DaMon-14/Micromouse/resources/links.txt

https://wiki.st.com/stm32mcu/wiki/Getting_started_with_SPI
https://www.youtube.com/watch?v=vKyL43qXPpk
http://greenye.net/
