DaMon-14/Micromouse/piese.xlsx

Sheet: parts
item # | component | manufacturer | vendor | Qty | Unit price no TVA | Unit price | Total Price | Y/N | min qty | Notes | In stock | Url | Alt Url
1 | NUCLEO-F411RE | STMicroelectronics | TME | 1 | 104.31 | 104.31 | 104.31 | 1 | 1 |  | 0 | NUCLEO-F411RE STMicroelectronics - Kituri dezv: STM32 | Comp: STM32F411RET6; Conectori de extensie: 2 | Transfer Multisort Elektronik România (https://www.tme.eu/ro/details/nucleo-f411re/kituri-de-dezvoltare-stm/stmicroelectronics/) | NUCLEO-F411RE STMicroelectronics | Embedded MCU, DSP Evaluation Boards | DigiKey (https://www.digikey.ro/en/products/detail/stmicroelectronics/NUCLEO-F411RE/4866485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)
2 | LSM6DSOXTR test board | Arduino | TME | 1 | 73.54 | 73.54 | 73.54 | 1 | 1 |  | 0 | MODULINO MOVEMENT ARDUINO - Modul de extensie | cablu de conectare,modul; Comp: LSM6DSOX; ABX00101 | Transfer Multisort Elektronik România (https://www.tme.eu/ro/details/abx00101/solutii-arduino/arduino/modulino-movement/) | 4438 Adafruit Industries LLC | Expansion Boards, Daughter Cards | DigiKey (https://www.digikey.ro/en/products/detail/adafruit-industries-llc/4438/11497501)
3 | 8.00M-SMDHC49S | YIC | TME | 10 | 1.44 | 1.44 | 14.4 | 1 | 10 |  | 0 | 8.00M-SMDHC49S YIC - Cristal | 8MHz; SMD; 20pF; ±30ppm; ±5ppm/an; 1mW; HC49SM; -20÷70°C | Transfer Multisort Elektronik România (https://www.tme.eu/ro/details/8.00m-smdhc49s/resonators-and-generators/yic/) | ABLS-8.000MHZ-B4-T Abracon LLC | Crystals | DigiKey (https://www.digikey.ro/en/products/detail/abracon-llc/ABLS-8-000MHZ-B4-T/2184155)
4 | RGB LED | REFOND | TME | 5 | 0.82 | 0.82 | 4.1 | 1 | 5 |  | 0 | RF-W7SP30TS-A44 REFOND - LED | RGB; SMD; PLCC6; 1,8÷2,4/2,7÷3,4/2,7÷3,4VDC; 3,5x2,8x1,8mm | Transfer Multisort Elektronik România (https://www.tme.eu/ro/details/rf-w7sp30ts-a44/diode-led-smd-colorate/refond/) | CLMVC-FKA-CL1D1L71BB7C3C3 Cree LED | LED Indication - Discrete | DigiKey (https://www.digikey.ro/en/products/detail/cree-led/CLMVC-FKA-CL1D1L71BB7C3C3/4794065)
18 | HC-05 |  | Sigmanortec | 1 |  | 27.04 | 27.04 | 1 | 1 |  | 1 | Modul Bluetooth HC-05 compatibil Arduino Master/Slave (https://sigmanortec.ro/Modul-Bluetooth-HC-05-p141736971)
19 | SS14 |  | Sigmanortec | 10 |  | 0.3 | 3 | 1 | 1 |  | 1 | Dioda Schottky 1N5819 SMD SS14 40V 1A (https://sigmanortec.ro/Dioda-Schottky-1N5819-SMD-SS14-40V-p128704286)
20 | Button |  | Sigmanortec | 10 |  | 0.73 | 7.3 | 1 | 1 |  | 1 | Buton micro fara retinere 4x4x1.6mm, 4 pini metalic (https://sigmanortec.ro/Buton-micro-fara-retinere-1-6mm-p125704779)
21 | HPCB 30:1 1000rpm |  | Sigmanortec | 3 |  | 38.72 | 116.16 | 1 | 1 |  | 0 | Motor DC Micro Metal N20 6V HPCB perii carbon 30:1 (https://sigmanortec.ro/Motor-DC-Micro-Metal-6V-HPCB-Perii-Carbon-30-1-p200733572)
22 | coreless motor |  | Sigmanortec | 3 |  | 12.63 | 37.89 | 1 | 1 |  | 0 | Motor mini coreless 20x8.5 ax 1mm 50000RPM 3.7V drone (https://sigmanortec.ro/Motor-mini-coreless-20x8-5-ax-1mm-50000RPM-p209682505)
5 | NOVOSENSE MT6701CT-ACD | NOVOSENSE | LCSC | 4 | 9.54 | 11.5434 | 46.1736 | 1 | 1 |  | 0 | MT6701CT-ACD | Angle, Linear Position Measuring | NOVOSENSE | LCSC (https://www.lcsc.com/product-detail/C50203010.html?s_z=n_q_MT6701CT-ACD)
6 | TB6612FNG | Toshiba Semiconductor and Storage | LCSC | 2 | 5.4 | 6.534 | 13.068 | 1 | 1 |  | 0 | TB6612FNG,C,8,EL | Motor Drivers, Controllers | TOSHIBA | LCSC (https://www.lcsc.com/product-detail/C141517.html?s_z=n_q_TB6612FNG) | TB6612FNG,C,8,EL Toshiba Semiconductor and Storage | Motor Drivers, Controllers | DigiKey (https://www.digikey.ro/en/products/detail/toshiba-semiconductor-and-storage/TB6612FNG-C-8-EL/1730070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)
7 | TEFT4300 | Vishay Semiconductor Opto Division | LCSC | 10 | 1.09 | 1.3189 | 13.189 | 1 | 5 |  | 0 | TEFT4300 | Phototransistors | VISHAY | LCSC (https://www.lcsc.com/product-detail/C118301.html?s_z=n_q_TEFT4300) | TEFT4300 Vishay Semiconductor Opto Division | Phototransistors | DigiKey (https://www.digikey.ro/en/products/detail/vishay-semiconductor-opto-division/TEFT4300/1681175)
8 | STM32F411RET6 | STMicroelectronics | LCSC | 2 | 21.18 | 25.6278 | 51.2556 | 1 | 1 |  | 0 | STM32F411RET6 | Microcontrollers | ST | LCSC (https://www.lcsc.com/product-detail/C94355.html?s_z=n_q_STM32F411RET6) | STM32F411RET6 STMicroelectronics | Microcontrollers | DigiKey (https://www.digikey.ro/en/products/detail/stmicroelectronics/STM32F411RET6/4935722)
9 | LSM6DSOXTR | STMicroelectronics | LCSC | 1 | 17.67 | 21.3807 | 21.3807 | 1 | 1 |  | 0 | LSM6DSOXTR | IMUs (Inertial Measurement Units) | ST | LCSC (https://www.lcsc.com/product-detail/C481766.html?s_z=n_q_LSM6DSOXTR) | LSM6DSOXTR STMicroelectronics | IMUs (Inertial Measurement Units) | DigiKey (https://www.digikey.ro/en/products/detail/stmicroelectronics/LSM6DSOXTR/9841882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)
10 | TSAL6100 | Vishay Semiconductor Opto Division | LCSC | 10 | 0.92 | 1.1132 | 11.132 | 1 | 5 |  | 0 | TSAL6100 | LED Emitters - Infrared, UV, Visible | VISHAY | LCSC (https://www.lcsc.com/product-detail/C111836.html?s_z=n_q_TSAL6100) | TSAL6100 Vishay Semiconductor Opto Division | LED Emitters - Infrared, UV, Visible | DigiKey (https://www.digikey.ro/en/products/detail/vishay-semiconductor-opto-division/TSAL6100/1681338)
11 | BPV10NF | Vishay Semiconductor Opto Division | LCSC | 10 | 2.52 | 3.0492 | 30.492 | 0.5 | 10 |  | 0 | BPV10NF | Photodiodes | VISHAY | LCSC (https://www.lcsc.com/product-detail/C118288.html?s_z=n_q_BPV10NF) | BPV10NF Vishay Semiconductor Opto Division | Photodiodes | DigiKey (https://www.digikey.ro/en/products/detail/vishay-semiconductor-opto-division/BPV10NF/1681136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)
12 | TLV9062IDR | Texas Instruments | LCSC | 10 | 0.71 | 0.8591 | 8.591 | 0.5 | 5 |  | 0 | TLV9062IDR | Instrumentation, Op Amps, Buffer Amps | TI | LCSC (https://www.lcsc.com/product-detail/C398355.html?s_z=n_q_x_TLV9062IDR) | TLV9062IDR Texas Instruments | Instrumentation, Op Amps, Buffer Amps | DigiKey (https://www.digikey.ro/en/products/detail/texas-instruments/TLV9062IDR/7364940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)
13 | AO3400A | UMW | LCSC | 50 | 0.31 | 0.3751 | 18.755 | 1 | 10 |  | 0 | AO3400A | Single FETs, MOSFETs | AOS | LCSC (https://www.lcsc.com/product-detail/C20917.html?s_z=n_q_AO3400A) | AO3400A UMW | Single FETs, MOSFETs | DigiKey (https://www.digikey.ro/en/products/detail/umw/AO3400A/16705910)
14 | AP62300Z6-7 | Diodes Incorporated | LCSC | 10 | 0.96 | 1.1616 | 11.616 | 1 | 5 |  | 0 | AP62300Z6-7 | Voltage Regulators - DC DC Switching Regulators | DIODES | LCSC (https://www.lcsc.com/product-detail/C5250745.html?s_z=n_q_AP62300Z6-7) | AP62300Z6-7 Diodes Incorporated | Voltage Regulators - DC DC Switching Regulators | DigiKey (https://www.digikey.ro/en/products/detail/diodes-incorporated/AP62300Z6-7/16547279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)
15 | APV APH0420T3R3M | APV | LCSC | 10 | 0.42 | 0.5082 | 5.082 | 1 | 5 |  | 0 | APH0420T3R3M | Fixed Inductors | APV | LCSC (https://www.lcsc.com/product-detail/C5349667.html?s_z=n_q_t_3.3uH) | NRS5040T3R3NMGJ Taiyo Yuden | Fixed Inductors | DigiKey (https://www.digikey.ro/en/products/detail/taiyo-yuden/NRS5040T3R3NMGJ/4970846)
16 | TLV75533PDBVR | Texas Instruments | LCSC | 10 | 0.78 | 0.9438 | 9.438 | 1 | 5 |  | 0 | TLV75533PDBVR | Voltage Regulators - Linear, Low Drop Out (LDO) Regulators | TI | LCSC (https://www.lcsc.com/product-detail/C404027.html?s_z=n_q_TLV75533PDBVR) | TLV75533PDBVR Texas Instruments | Voltage Regulators - Linear, Low Drop Out (LDO) Regulators | DigiKey (https://www.digikey.ro/en/products/detail/texas-instruments/TLV75533PDBVR/9356541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)
17 | TVS encoder | TECH PUBLIC | LCSC | 20 | 0.14 | 0.1694 | 3.388 | 1 | 20 |  | 0 | PESD3V3U1UL | TVS Diodes | TECH PUBLIC | LCSC (https://www.lcsc.com/product-detail/C19829543.html?s_z=n_q_ESD3V3U1U)
23 | magnet |  |  |  |  | 0 | 0 | 1 |  |  | 1 | DecoHobbyArt, or any other generic magnets
 | Total Price
 | 631.3009
 |  |  |  |  |  | 243.56

Sheet: parts_old
part & likelyhood of purchase | link | price/pcs | pcs | price | Obs | purchased? | JLCPCB avalibility | JLCPCB price | Obs
SLM6DSOX | MODULINO MOVEMENT ARDUINO - Modul de extensie | cablu de conectare,modul; Comp: LSM6DSOX; ABX00101 | Transfer Multisort Elektronik România (https://www.tme.eu/ro/details/abx00101/solutii-arduino/arduino/modulino-movement/) | 60.87 | 1 | 60.87
NUCELO-F411RE | NUCLEO-F411RE STMicroelectronics - Kituri dezv: STM32 | Comp: STM32F411RET6; Conectori de extensie: 2 | Transfer Multisort Elektronik România (https://www.tme.eu/ro/details/nucleo-f411re/kituri-de-dezvoltare-stm/stmicroelectronics/) | 86.63 | 1 | 86.63
TSAL6200 | TSAL6200 VISHAY - Emiţător IR | 5mm; 940nm; gri-albăstrui,transparent; 210mW; 17° | Transfer Multisort Elektronik România (https://www.tme.eu/ro/details/tsal6200/diode-led-ir/vishay/) | 1.35 | 10 | 13.5 | price 10 buc min
TSAL6100 | TSAL6100 VISHAY - Emiţător IR | 5mm; 940nm; gri-albăstrui,transparent; 40mW; THT | Transfer Multisort Elektronik România (https://www.tme.eu/ro/details/tsal6100/diode-led-ir/vishay/) | 1.79 | 10 | 17.9 | price 10 buc min
SFH4544 | SFH 4544 ams OSRAM - Emiţător IR | 5mm; 950nm; neagră; 550mW; 10°; 1,6÷1,9VDC; THT; 100mA; SFH4544 | Transfer Multisort Elektronik România (https://www.tme.eu/ro/details/sfh4544/diode-led-ir/ams-osram/sfh-4544/) | 2.24 | 10 | 22.4 | price 10 buc min |  | 34 in stock only | 2.37 | price 10 buc min
VBPW34S | VBPW34S VISHAY - Fotodiodă PIN | Gull wing; SMD; 940nm; 430÷1100nm; 130°; plat | Transfer Multisort Elektronik România (https://www.tme.eu/ro/details/vbpw34s/fotodiode/vishay/) | 3.78 | 10 | 37.8 | price 10 buc min |  |  | 2.18 | price 10 buc min
BPV10NF | BPV10NF VISHAY - Fotodiodă IR PIN | 5mm; THT; 940nm; 40° | Transfer Multisort Elektronik România (https://www.tme.eu/ro/details/bpv10nf/fotodiode/vishay/) | 3.16 | 10 | 31.6 | price 10 buc min |  |  | 2.46 | price 10 buc min
TLV9062IDR | TLV9062IDR TEXAS INSTRUMENTS - IC: amplificator operaţional | 10MHz; Ch: 2; 1,8÷5,5VDC; SO8; 2mV | Transfer Multisort Elektronik România (https://www.tme.eu/ro/details/tlv9062idr/amplificatori-operationali-smd/texas-instruments/) | 3.61 | 10 | 36.1 | price 10 buc min |  |  | 0.64
AO3400A | AO3400A ALPHA & OMEGA SEMICONDUCTOR - Tranzistor: N-MOSFET | unipolar; 30V; 4,7A; 1,4W; SOT23 | Transfer Multisort Elektronik România (https://www.tme.eu/ro/details/ao3400a/tranzistori-canal-n-smd/alpha-omega-semiconductor/) | 0.37 | 50 | 18.5 | price 50 buc min |  |  | 0.38
TCTR5000 | TCRT5000 2.5mm reflective optical sensor for line robots (https://sigmanortec.ro/en/tcrt5000-optical-sensor-reflective) | 3.55 | 10 | 35.5 | backup if photodiode is problematic
Motor | Motor DC mini N20 500RPM 6V cu reductor metalic (https://sigmanortec.ro/Motor-DC-mini-angrenaje-metal-N20-500RPM-p211611036) | 22.46 | 3 | 67.38 | no encoder, may be changed with 1000rpm HPCB variant from sigmanortec
DRV8833 | DRV8833 dual H-bridge 1.5A Arduino motor driver module (https://sigmanortec.ro/en/motor-driver-module-dual-h-bridge-drv8833-15a) | 6.09 | 1 | 6.09 |  |  |  | 10.38
turbine motor | Motor mini coreless 20x8.5 ax 1mm 50000RPM 3.7V drone (https://sigmanortec.ro/Motor-mini-coreless-20x8-5-ax-1mm-50000RPM-p209682505) | 12.63 | 4 | 50.52
8Mhz quartz | 8.00M-SMDHC49S YIC - Cristal | 8MHz; SMD; 20pF; ±30ppm; ±5ppm/an; 1mW; HC49SM; -20÷70°C | Transfer Multisort Elektronik România (https://www.tme.eu/ro/details/8.00m-smdhc49s/resonators-and-generators/yic/) | 1.19 | 10 | 11.9 | price 10 buc min
Pogo pins | 303A-753018-000 ATTEND - Conector: pogo pin | PIN: 1; SMT; Ø: 1,05mm; Hmin: 6,2mm; Hmax: 7,5mm | Transfer Multisort Elektronik România (https://www.tme.eu/ro/details/303a-753018-000/alti-conectori/attend/) | 2.74 | 5 | 13.7 | price 5 buc min
AP62300Z6-7 | AP62300Z6-7 DIODES INCORPORATED - PMIC | convertor DC/DC; Uintr: 4,2÷18VDC; Uieş: 0,8÷7VDC; 3A; SOT563 | Transfer Multisort Elektronik România (https://www.tme.eu/ro/details/ap62300z6-7/regulatoare-de-tensiune-circuite-dc-dc/diodes-incorporated/) | 1.11 | 10 | 11.1 | price 10 bun min |  |  | 0.73
3.3uH inductor | NRS5030T3R3MMGJ TAIYO YUDEN - Inductor: fir | SMD; 3,3uH; 3A; R: 30mΩ; ±20%; NRS; 4,9x4,9mm | Transfer Multisort Elektronik România (https://www.tme.eu/ro/details/nrs5030t3r3mmgj/inductoare/taiyo-yuden/) | 0.57 | 10 | 5.7 | price 10 buc min |  |  |  | hand solder prob
TLV75533PDBVR | TLV75533PDBVR TEXAS INSTRUMENTS - IC: stabilizator de tensiune | LDO,liniar,nereglabil; 3,3V; 500mA | Transfer Multisort Elektronik România (https://www.tme.eu/ro/details/tlv75533pdbvr/regulatoare-de-tensiune-neregulata-ldo/texas-instruments/) | 1.28 | 5 | 6.4 | price 5 buc min |  |  | 0.73
State led | RF-W7SP30TS-A44 REFOND - LED | RGB; SMD; PLCC6; 1.8÷2.4/2.7÷3.4/2.7÷3.4VDC; 3.5x2.8x1.8mm | Transfer Multisort Elektronik Romania (https://www.tme.eu/ro/en/details/rf-w7sp30ts-a44/smd-colour-leds/refond/) | 0.5 | 25 | 12.5 | price 25 buc min
Button | Buton micro fara retinere 4x4x1.6mm, 4 pini metalic (https://sigmanortec.ro/Buton-micro-fara-retinere-1-6mm-p125704779) | 0.73 | 5 | 3.65
SS14 | Dioda Schottky 1N5819 SMD SS14 40V 1A (https://sigmanortec.ro/Dioda-Schottky-1N5819-SMD-SS14-40V-p128704286) | 0.3 | 10 | 3 |  |  |  | 0.05
BLE | Modul Bluetooth HC-05 compatibil Arduino Master/Slave (https://sigmanortec.ro/Modul-Bluetooth-HC-05-p141736971) | 27.04 | 1 | 27.04
 |  | 479.04

Sheet: general
part | link | price (ron) /pcs | pcs | price (ron) | OK/NOT OK | Obs
STM32 | https://www.digikey.com/en/products/detail/stmicroelectronics/STM32F411RET6/4935722 | 34.35 | 3 | 103.05
 | https://www.tme.eu/ro/details/stm32f411ret6/microcontrolere-st/stmicroelectronics/ | 49.77 | 3 | 149.31 |  | min 3 pcs for that price
nucleo | https://www.digikey.com/en/products/detail/stmicroelectronics/NUCLEO-F411RE/4866485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 | 86.67 | 1 | 86.67
 | https://www.tme.eu/ro/details/nucleo-f411re/kituri-de-dezvoltare-stm/stmicroelectronics/ | 86.35 | 1 | 86.35
 | https://botland.store/stm32-nucleo/3363-stm32-nucleo-f411re-module-stm32f411re-arm-cortex-m4-5904422331764.html | 104.67 | 1 | 104.67
motors | https://www.pololu.com/product/5187 | 149.44 | 2 | 298.88 |  | pricy shiping
 | https://robomaniacs.ro/product/micromotor-cu-angrenaj-core-6v/ | 120 | 2 | 240 |  | 750rpm no encoder
 | https://www.dfrobot.com/product-1431.html | 54.8 | 3 | 164.4 |  | 530rpm encoder | drfobot 18usd shiping
 | https://botland.store/dc-micro-motors-with-gearbox/5093-hpcb-motor-with-50-1-gear-doublesided-shaft-pololu-3073-5904422306359.html |  |  | 0 |  | w/o encoder | https://botland.store/encoders/8258-magnetic-encoder-pair-kit-for-20d-mm-metal-gearmotors-20-cpr-27-18v-pololu-3499-5904422375782.html
 |  |  |  | 0
 |  |  |  | 0
 |  |  |  | 0
 |  |  |  | 0
 |  |  |  | 0
 |  |  |  | 0
 |  |  |  | 0
