DaMon-14/Micromouse/p.xlsx

Sheet: Sheet1
part & liklyhood of purchase | link | price/pcs | pcs | price | Obs | JLCPCB avalibility | JLCPCB price | Obs
SLM6DSOX | MODULINO MOVEMENT ARDUINO - Modul de extensie | cablu de conectare,modul; Comp: LSM6DSOX; ABX00101 | Transfer Multisort Elektronik România (https://www.tme.eu/ro/details/abx00101/solutii-arduino/arduino/modulino-movement/) | 60.87 | 1 | 60.87
NUCELO-F411RE | NUCLEO-F411RE STMicroelectronics - Kituri dezv: STM32 | Comp: STM32F411RET6; Conectori de extensie: 2 | Transfer Multisort Elektronik România (https://www.tme.eu/ro/details/nucleo-f411re/kituri-de-dezvoltare-stm/stmicroelectronics/) | 86.63 | 1 | 86.63
TSAL6200 | TSAL6200 VISHAY - Emiţător IR | 5mm; 940nm; gri-albăstrui,transparent; 210mW; 17° | Transfer Multisort Elektronik România (https://www.tme.eu/ro/details/tsal6200/diode-led-ir/vishay/) | 1.35 | 10 | 13.5 | price 10 buc min
TSAL6100 | TSAL6100 VISHAY - Emiţător IR | 5mm; 940nm; gri-albăstrui,transparent; 40mW; THT | Transfer Multisort Elektronik România (https://www.tme.eu/ro/details/tsal6100/diode-led-ir/vishay/) | 1.79 | 10 | 17.9 | price 10 buc min
SFH4544 | SFH 4544 ams OSRAM - Emiţător IR | 5mm; 950nm; neagră; 550mW; 10°; 1,6÷1,9VDC; THT; 100mA; SFH4544 | Transfer Multisort Elektronik România (https://www.tme.eu/ro/details/sfh4544/diode-led-ir/ams-osram/sfh-4544/) | 2.24 | 10 | 22.4 | price 10 buc min | 34 in stock only | 2.37 | price 10 buc min
VBPW34S | VBPW34S VISHAY - Fotodiodă PIN | Gull wing; SMD; 940nm; 430÷1100nm; 130°; plat | Transfer Multisort Elektronik România (https://www.tme.eu/ro/details/vbpw34s/fotodiode/vishay/) | 3.78 | 10 | 37.8 | price 10 buc min |  | 2.18 | price 10 buc min
BPV10NF | BPV10NF VISHAY - Fotodiodă IR PIN | 5mm; THT; 940nm; 40° | Transfer Multisort Elektronik România (https://www.tme.eu/ro/details/bpv10nf/fotodiode/vishay/) | 3.16 | 10 | 31.6 | price 10 buc min |  | 2.46 | price 10 buc min
TLV9062IDR | TLV9062IDR TEXAS INSTRUMENTS - IC: amplificator operaţional | 10MHz; Ch: 2; 1,8÷5,5VDC; SO8; 2mV | Transfer Multisort Elektronik România (https://www.tme.eu/ro/details/tlv9062idr/amplificatori-operationali-smd/texas-instruments/) | 3.61 | 10 | 36.1 | price 10 buc min |  | 0.64
AO3400A | AO3400A ALPHA & OMEGA SEMICONDUCTOR - Tranzistor: N-MOSFET | unipolar; 30V; 4,7A; 1,4W; SOT23 | Transfer Multisort Elektronik România (https://www.tme.eu/ro/details/ao3400a/tranzistori-canal-n-smd/alpha-omega-semiconductor/) | 0.37 | 50 | 18.5 | price 50 buc min |  | 0.38
TCTR5000 | TCRT5000 VISHAY - Senzor: optocuplor | 32V; OUT: tranzistori | Transfer Multisort Elektronik România (https://www.tme.eu/ro/details/tcrt5000/senzori-fotoelectrici-pt-pcb/vishay/) | 4.36 | 10 | 43.6 | price 10 buc min
 | TCRT5000 Photoelectric Sensor (https://www.optimusdigital.ro/en/optical-sensors/42-tcrt5000-photoelectric-sensor.html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) | 1.79 | 10 | 17.9
Motor | GA12 N20 Encoder DC 6V Mini Micro Metal Gear DC Motor Gearwheel High Torque 15 25 50 70 100 150 300 500 1500RPM 7PPR Hall Sensor - AliExpress (https://www.aliexpress.com/item/1005007470598651.html?curPageLogUid=8oZNRbGJaPtW) | 22.78 | 4 | 91.12
DRV8833 | DRV8833 dual H-bridge 1.5A Arduino motor driver module (https://sigmanortec.ro/en/motor-driver-module-dual-h-bridge-drv8833-15a) | 6.09 | 1 | 6.09 |  |  | 10.38
turbine motor | Mini coreless motor 20x7mm 50000RPM 3.7V for drones (https://sigmanortec.ro/en/mini-coreless-motor-20x7-1mm-shaft-50000rpm-37v) | 11.07 | 2 | 22.14
 |  |  |  | 0
 |  |  |  | 0
 |  |  |  | 0
 |  |  |  | 0
 |  |  |  | 251.6

Sheet: Sheet2
JGA12-N20 miniature gear motor 6v12v electronic intelligent lock metal gear motor - AliExpress 13 (https://www.aliexpress.com/item/1005010758862650.html?spm=a2g0o.store_pc_home.0.0.34d25cbb0B7CQ3)
HDS242S OWON - Osciloscop portabil | 40MHz; 8bit; LCD 3,5"; Ch: 2; 250Msps; 8kpts | Transfer Multisort Elektronik România (https://www.tme.eu/ro/details/hds242s/osciloscoape-portabile-scopometre/owon/)
HDS2202S OWON - Osciloscop portabil | 200MHz; 8bit; LCD 3,5"; Ch: 2; 1Gsps; 8kpts | Transfer Multisort Elektronik România (https://www.tme.eu/ro/details/hds2202s/osciloscoape-portabile-scopometre/owon/)
HANTEK2C42 HANTEK - Osciloscop portabil | 40MHz; 8bit; color,LCD TFT 2,8"; Ch: 2; 6kpts; 2C42 | Transfer Multisort Elektronik România (https://www.tme.eu/ro/details/2c42/osciloscoape-portabile-scopometre/hantek/hantek2c42/)
