DaMon-14/Micromouse/KiCad/PCB_V1/PCB_V1.kicad_sch

## KiCad design KiCad/PCB_V1/PCB_V1.kicad_sch (2026-10-25)

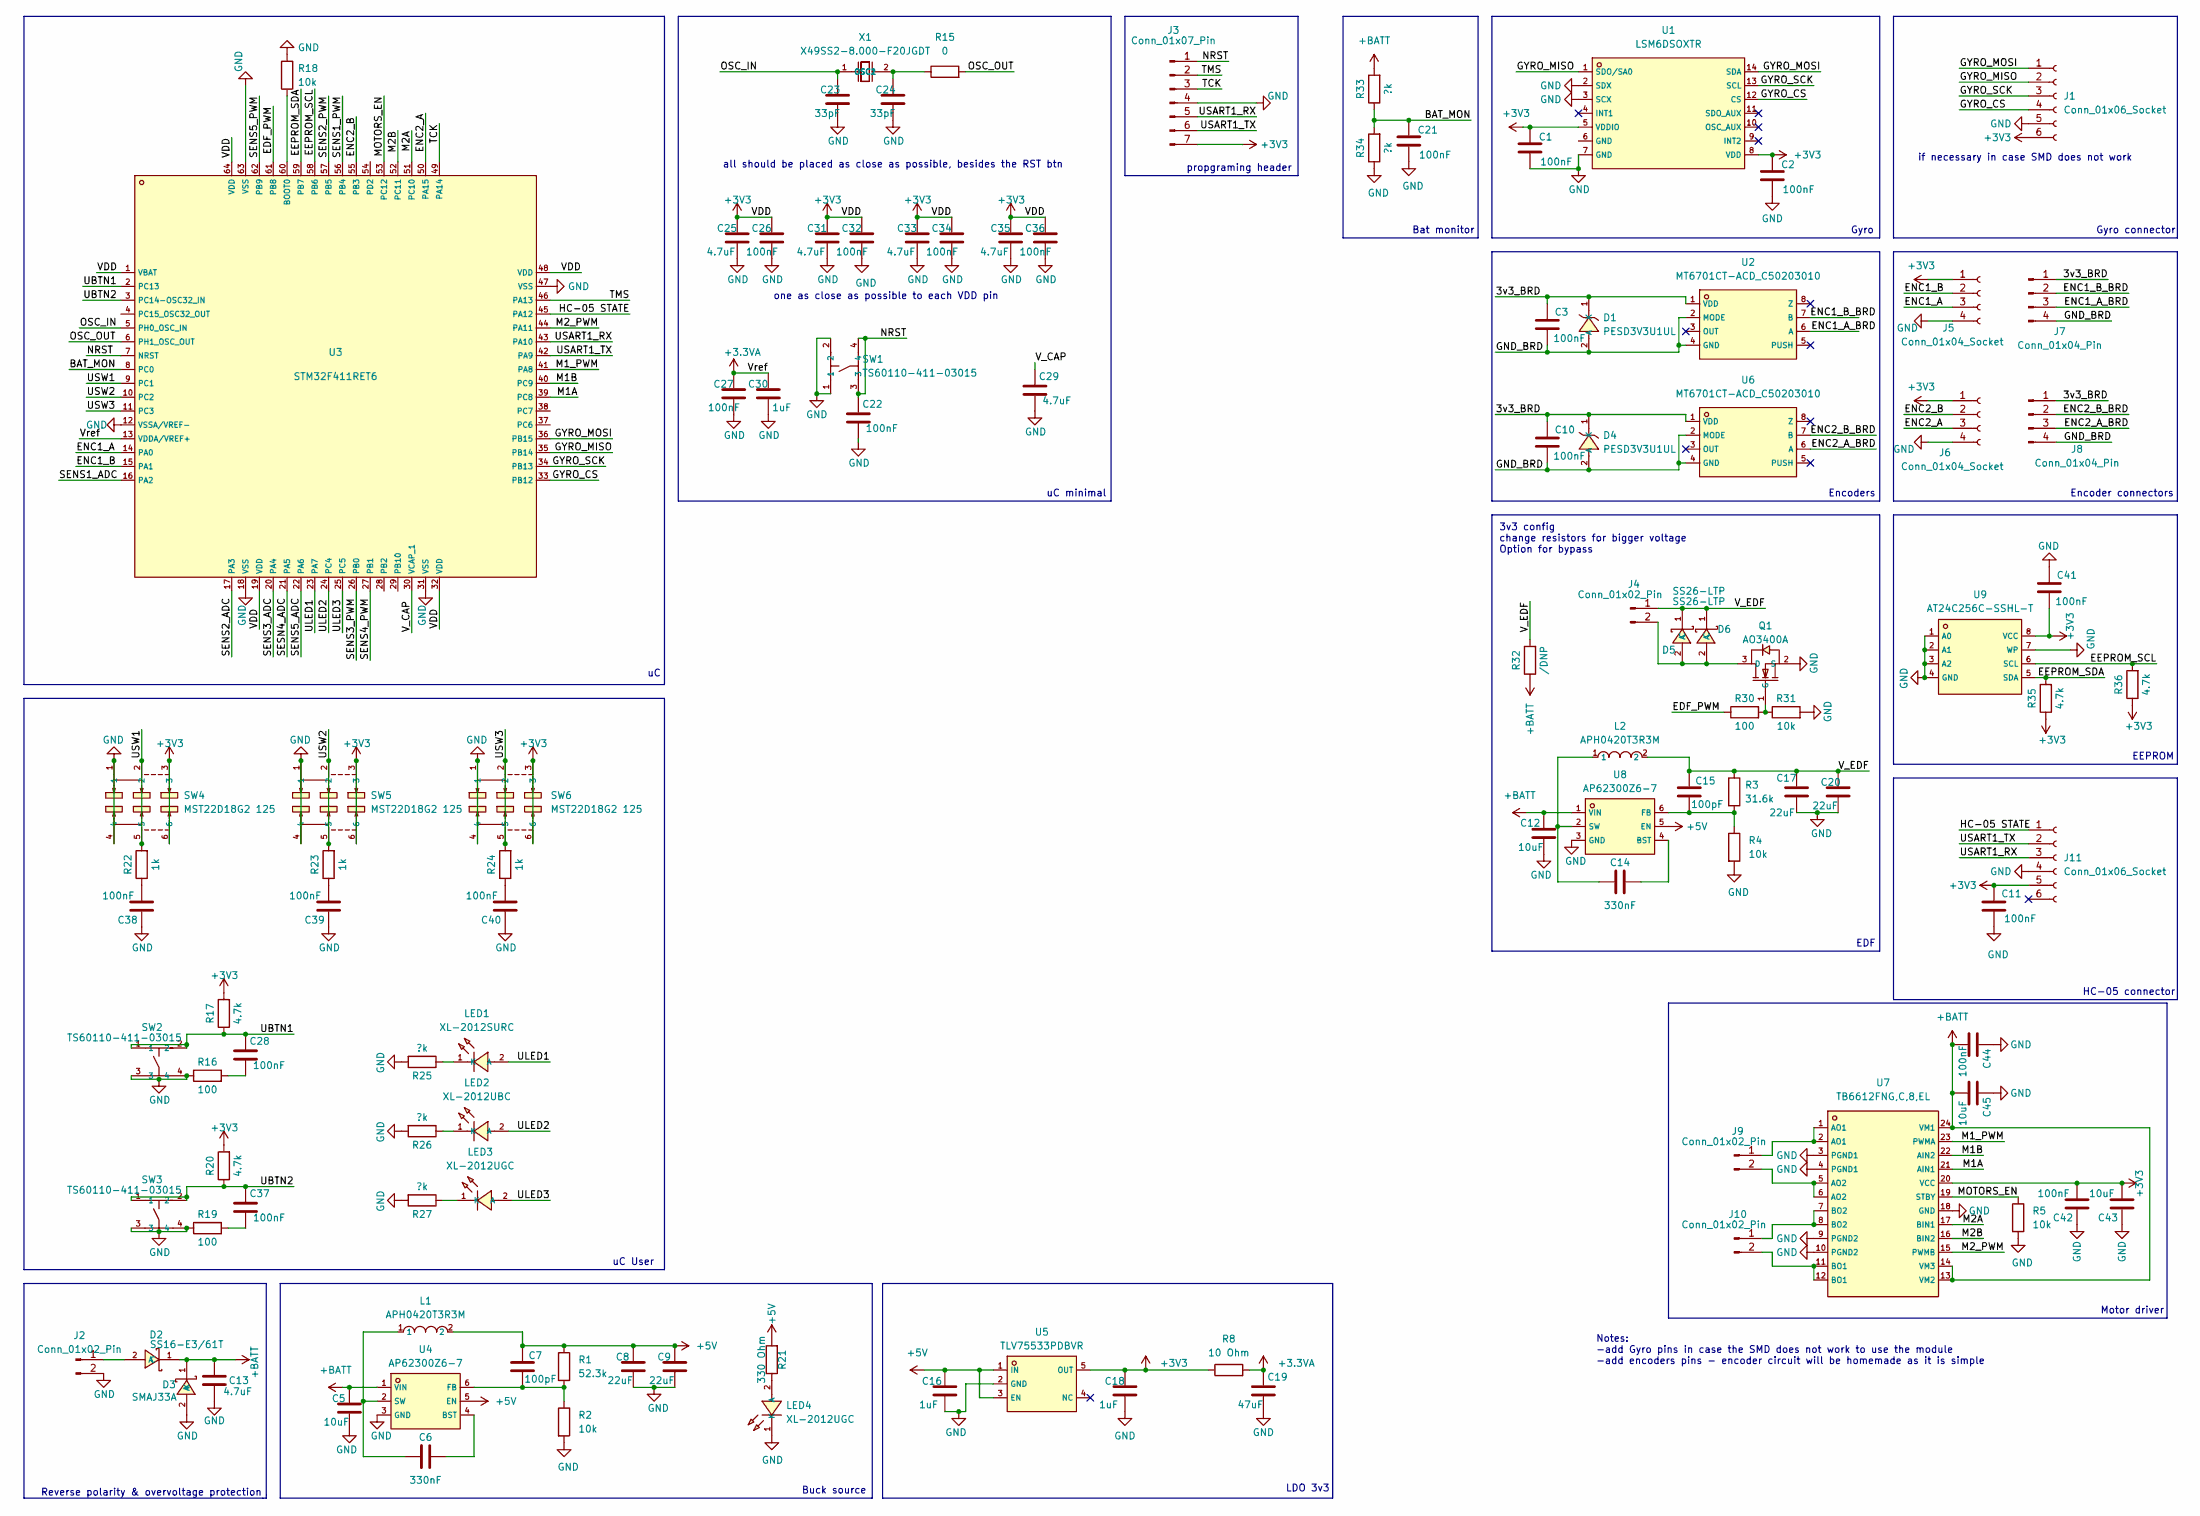
[picture p1: schematic PCB_V1.kicad_sch]

Parts:
C1, C2, C3, C10, C11, C21, C22, C26, C27, C28, C32, C34, C36, C37, C38, C39, C40, C41, C42, C44: 100nF; C_0805_2012Metric_Pad1.18x1.45mm_HandSolder
C5, C12, C43, C45: 10uF; C_0805_2012Metric_Pad1.18x1.45mm_HandSolder
C6, C14: 330nF; C_0805_2012Metric_Pad1.18x1.45mm_HandSolder
C7, C15: 100pF; C_0805_2012Metric_Pad1.18x1.45mm_HandSolder
C8, C9, C17, C20: 22uF; C_0805_2012Metric_Pad1.18x1.45mm_HandSolder
C13, C25, C29, C31, C33, C35: 4.7uF; C_0805_2012Metric_Pad1.18x1.45mm_HandSolder
C16, C18, C30: 1uF; C_0805_2012Metric_Pad1.18x1.45mm_HandSolder
C19: 47uF; C_0805_2012Metric_Pad1.18x1.45mm_HandSolder
C23, C24: 33pF; C_0805_2012Metric_Pad1.18x1.45mm_HandSolder
D1, D4: PESD3V3U1UL; C19829543_SOD-882_L1_0-W0_6-RD; LCSC C19829543
D2: SS16-E3/61T; C183023_SMA_L4_3-W2_6-LS5_2-RD; LCSC C183023
D3: SMAJ33A; C223988_SMA_L4_3-W2_6-LS5_0-RD; LCSC C223988
D5, D6: SS26-LTP; C85690_SMA_L4_3-W2_6-LS5_2-RD; LCSC C85690
J1, J11: Conn_01x06_Socket; PinSocket_1x06_P2.54mm_Vertical
J2, J4, J9, J10: Conn_01x02_Pin; PinHeader_1x02_P2.54mm_Vertical
J3: Conn_01x07_Pin; PinHeader_1x07_P2.54mm_Vertical
J5, J6: Conn_01x04_Socket; PinSocket_1x04_P2.54mm_Vertical
J7, J8: Conn_01x04_Pin; PinSocket_1x04_P2.54mm_Vertical
L1, L2: APH0420T3R3M; C5349667_IND-SMD_L4_4-W4_2; LCSC C5349667
LED1: XL-2012SURC; C965812_LED0805-RD_RED; LCSC C965812
LED2: XL-2012UBC; C965817_LED0805-RD; LCSC C965817
LED3, LED4: XL-2012UGC; C965815_LED0805-RD_GREEN; LCSC C965815
Q1: AO3400A; C20917_SOT-23-3_L2_9-W1_3-P1_90-LS2_4-BR; LCSC C20917
R1: 52.3k; R_0805_2012Metric_Pad1.20x1.40mm_HandSolder
R2, R4, R5, R18, R31: 10k; R_0805_2012Metric_Pad1.20x1.40mm_HandSolder
R3: 31.6k; R_0805_2012Metric_Pad1.20x1.40mm_HandSolder
R8: 10 Ohm; R_0805_2012Metric_Pad1.20x1.40mm_HandSolder
R15: 0; R_0805_2012Metric_Pad1.20x1.40mm_HandSolder
R16, R19, R30: 100; R_0805_2012Metric_Pad1.20x1.40mm_HandSolder
R17, R20, R35, R36: 4.7k; R_0805_2012Metric_Pad1.20x1.40mm_HandSolder
R21: 330 Ohm; R_0805_2012Metric_Pad1.20x1.40mm_HandSolder
R22, R23, R24: 1k; R_0805_2012Metric_Pad1.20x1.40mm_HandSolder
R25, R26, R27, R33, R34: ?k; R_0805_2012Metric_Pad1.20x1.40mm_HandSolder
R32: /DNP; R_0805_2012Metric_Pad1.20x1.40mm_HandSolder
SW1, SW2, SW3: TS60110-411-03015; C42400889_SW-SMD_4P-L5_2-W5_2-P3_70-LS6_4-BL; LCSC C42400889
SW4, SW5, SW6: MST22D18G2 125; C2906280_SW-SMD_MST22D18G2; LCSC C2906280
U1: LSM6DSOXTR; C481766_LGA-14L_L3_0-W2_5-P0_50-TL; LCSC C481766
U2, U6: MT6701CT-ACD_C50203010; C50203010_SOIC-8_L5_0-W4_0-P1_27-LS6_0-BL; LCSC C50203010
U3: STM32F411RET6; C94355_LQFP-64_L10_0-W10_0-P0_50-LS12_0-BL; LCSC C94355
U4, U8: AP62300Z6-7; C5250745_SOT-563-6_L1_6-W1_2-P0_50-LS1_6-BL; LCSC C5250745
U5: TLV75533PDBVR; C404027_SOT-23-5_L3_0-W1_7-P0_95-LS2_8-BR; LCSC C404027
U7: TB6612FNG,C,8,EL; C141517_SSOP-24_L8_3-W5_6-P0_65-LS7_6-BL; LCSC C141517
U9: AT24C256C-SSHL-T; C6482_SOIC-8_L4_9-W3_9-P1_27-LS6_0-BL; LCSC C6482
X1: X49SS2-8.000-F20JGDT; C2842263_CRYSTAL-SMD_L11_4-W4_7-LS12_7; LCSC C2842263

Connections:
3v3_BRD: C3.1, C10.1, D1.1 (K), D4.1 (K), J7.1, J8.1, U2.1 (VDD), U6.1 (VDD)
+3.3VA: C19.1, C27.1, C30.1, R8.2, U3.13 (VDDA/VREF+)
+3V3: C1.1, C2.1, C11.2, C18.1, C25.1, C26.1, C31.1, C32.1, C33.1, C34.1, C35.1, C36.1, C41.2, C42.2, C43.2, J1.6, J3.7, J5.1, J6.1, J11.5, R8.1, R17.2, R20.2, R35.1, R36.1, SW4.3, SW4.6, SW5.3, SW5.6, SW6.3, SW6.6, U1.5 (VDDIO), U1.8 (VDD), U3.1 (VBAT), U3.19 (VDD), U3.32 (VDD), U3.48 (VDD), U3.64 (VDD), U5.5 (OUT), U7.20 (VCC), U9.8 (VCC)
+5V: C7.1, C8.1, C9.1, C16.1, L1.2, R1.1, R21.2, U4.5 (EN), U5.1 (IN), U5.3 (EN), U8.5 (EN)
+BATT: C5.1, C12.1, C13.1, C44.2, C45.2, D2.1 (C), D3.1 (K), R32.1, R33.2, U4.1 (VIN), U7.13 (VM2), U7.14 (VM3), U7.24 (VM1), U8.1 (VIN)
BAT_MON: C21.1, R33.1, R34.2, U3.8 (PC0)
EDF_PWM: R30.1, U3.61 (PB8)
EEPROM_SCL: R36.2, U3.58 (PB6), U9.6 (SCL)
EEPROM_SDA: R35.2, U3.59 (PB7), U9.5 (SDA)
ENC1_A: J5.3, U3.14 (PA0)
ENC1_A_BRD: J7.3
ENC1_B: J5.2, U3.15 (PA1)
ENC1_B_BRD: J7.2
ENC2_A: J6.3, U3.50 (PA15)
ENC2_A_BRD: J8.3, U6.6 (A)
ENC2_B: J6.2, U3.55 (PB3)
ENC2_B_BRD: J8.2, U6.7 (B)
GND: C1.2, C2.2, C5.2, C8.2, C9.2, C11.1, C12.2, C13.2, C16.2, C17.2, C18.2, C19.2, C20.2, C21.2, C22.2, C23.2, C24.2, C25.2, C26.2, C27.2, C29.2, C30.2, C31.2, C32.2, C33.2, C34.2, C35.2, C36.2, C38.1, C39.1, C40.1, C41.1, C42.1, C43.1, C44.1, C45.1, D3.2 (A), J1.5, J2.2, J3.4, J5.4, J6.4, J11.4, LED4.1 (K), Q1.2 (S), R2.2, R4.2, R5.2, R16.1, R18.2, R19.1, R25.2, R26.2, R27.2, R31.2, R34.1, SW1.1, SW1.2, SW2.3, SW2.4, SW3.3, SW3.4, SW4.1, SW4.4, SW5.1, SW5.4, SW6.1, SW6.4, U1.2 (SDX), U1.3 (SCX), U1.7 (GND), U3.12 (VSSA/VREF-), U3.18 (VSS), U3.31 (VSS), U3.47 (VSS), U3.63 (VSS), U4.3 (GND), U5.2 (GND), U7.3 (PGND1), U7.4 (PGND1), U7.9 (PGND2), U7.10 (PGND2), U7.18 (GND), U8.3 (GND), U9.1 (A0), U9.2 (A1), U9.3 (A2), U9.4 (GND), U9.7 (WP)
GND_BRD: C3.2, C10.2, D1.2 (A), D4.2 (A), J7.4, J8.4, U2.2 (MODE), U2.4 (GND), U6.2 (MODE), U6.4 (GND)
GYRO_CS: J1.4, U1.12 (CS), U3.33 (PB12)
GYRO_MISO: J1.2, U1.1 (SDO/SA0), U3.35 (PB14)
GYRO_MOSI: J1.1, U1.14 (SDA), U3.36 (PB15)
GYRO_SCK: J1.3, U1.13 (SCL), U3.34 (PB13)
HC-05 STATE: J11.1, U3.45 (PA12)
M1A: U3.39 (PC8), U7.21 (AIN1)
M1B: U3.40 (PC9), U7.22 (AIN2)
M1_PWM: U3.41 (PA8), U7.23 (PWMA)
M2A: U3.51 (PC10), U7.17 (BIN1)
M2B: U3.52 (PC11), U7.16 (BIN2)
M2_PWM: U3.44 (PA11), U7.15 (PWMB)
MOTORS_EN: R5.1, U3.53 (PC12), U7.19 (STBY)
NRST: C22.1, J3.1, SW1.3, SW1.4, U3.7 (NRST)
unnamed: C6.1, U4.4 (BST)
unnamed: C6.2, L1.1, U4.2 (SW)
unnamed: C7.2, R1.2, R2.1, U4.6 (FB)
unnamed: C14.1, U8.4 (BST)
unnamed: C14.2, L2.1, U8.2 (SW)
unnamed: C15.2, R3.2, R4.1, U8.6 (FB)
unnamed: C24.1, R15.1, X1.2 (OSC2)
unnamed: C28.2, R16.2
unnamed: C37.2, R19.2
unnamed: C38.2, R22.1
unnamed: C39.2, R23.1
unnamed: C40.2, R24.1
unnamed: D2.2 (A), J2.1
unnamed: D5.2 (A), D6.2 (A), J4.2, Q1.3 (D)
unnamed: J9.1, U7.1 (AO1), U7.2 (AO1)
unnamed: J9.2, U7.5 (AO2), U7.6 (AO2)
unnamed: J10.1, U7.7 (BO2), U7.8 (BO2)
unnamed: J10.2, U7.11 (BO1), U7.12 (BO1)
unnamed: LED1.1 (K), R25.1
unnamed: LED2.1 (K), R26.1
unnamed: LED3.1 (K), R27.1
unnamed: LED4.2 (A), R21.1
unnamed: Q1.1 (G), R30.2, R31.1
unnamed: R18.1, U3.60 (BOOT0)
OSC_IN: C23.1, U3.5 (PH0_OSC_IN), X1.1 (OSC1)
OSC_OUT: R15.2, U3.6 (PH1_OSC_OUT)
SENS1_ADC: U3.16 (PA2)
SENS1_PWM: U3.56 (PB4)
SENS2_ADC: U3.17 (PA3)
SENS2_PWM: U3.57 (PB5)
SENS3_ADC: U3.20 (PA4)
SENS3_PWM: U3.26 (PB0)
SENS4_PWM: U3.27 (PB1)
SENS5_ADC: U3.22 (PA6)
SENS5_PWM: U3.62 (PB9)
SESN4_ADC: U3.21 (PA5)
TCK: J3.3, U3.49 (PA14)
TMS: J3.2, U3.46 (PA13)
UBTN1: C28.1, R17.1, SW2.1, SW2.2, U3.2 (PC13)
UBTN2: C37.1, R20.1, SW3.1, SW3.2, U3.3 (PC14-OSC32_IN)
ULED1: LED1.2 (A), U3.23 (PA7)
ULED2: LED2.2 (A), U3.24 (PC4)
ULED3: LED3.2 (A), U3.25 (PC5)
USART1_RX: J3.5, J11.3, U3.43 (PA10)
USART1_TX: J3.6, J11.2, U3.42 (PA9)
USW1: R22.2, SW4.2, SW4.5, U3.9 (PC1)
USW2: R23.2, SW5.2, SW5.5, U3.10 (PC2)
USW3: R24.2, SW6.2, SW6.5, U3.11 (PC3)
V_CAP: C29.1, U3.30 (VCAP_1)
V_EDF: C15.1, C17.1, C20.1, D5.1 (C), D6.1 (C), J4.1, L2.2, R3.1, R32.2

Notes on the sheet:
Bat monitor
Reverse polarity & overvoltage protection
LDO 3v3
Notes: -add Gyro pins in case the SMD does not work to use the module -add encoders pins - encoder circuit will be homemade as it is simple
Encoder connectors
Motor driver
EEPROM
if necessary in case SMD does not work
3v3 config change resistors for bigger voltage Option for bypass
EDF
uC User
one as close as possible to each VDD pin
propgraming header
uC minimal
Encoders
Gyro
all should be placed as close as possible, besides the RST btn
Buck source
HC-05 connector
Gyro connector
