DaMon-14/Micromouse/code_blocks/Robot/Robot.ioc

Mcu.UserName=STM32F411RETx
PA0-WKUP.GPIO_Label=ENC1_A
PA0-WKUP.Signal=S_TIM5_CH1
PA1.GPIO_Label=ENC1_B
PA1.Signal=S_TIM5_CH2
PA10.Signal=USART1_RX
PA11.GPIO_Label=M2_PWM
PA11.Signal=S_TIM1_CH4
PA12.GPIO_Label=HC-05 STATE
PA12.Signal=GPIO_Input
PA13.GPIO_Label=TMS
PA13.Signal=SYS_JTMS-SWDIO
PA14.GPIO_Label=TCK
PA14.Signal=SYS_JTCK-SWCLK
PA15.GPIO_Label=ENC2_A
PA15.Signal=S_TIM2_CH1_ETR
PA2.GPIO_Label=SENS1_ADC
PA2.Signal=ADCx_IN2
PA3.GPIO_Label=SENS2_ADC
PA3.Signal=ADCx_IN3
PA4.GPIO_Label=SENS3_ADC
PA4.Signal=ADCx_IN4
PA5.GPIO_Label=SESN4_ADC
PA5.Signal=ADCx_IN5
PA6.GPIO_Label=SENS5_ADC
PA6.Signal=ADCx_IN6
PA7.GPIO_Label=ULED1
PA7.Signal=GPIO_Output
PA8.GPIO_Label=M1_PWM
PA8.Signal=S_TIM1_CH1
PA9.Signal=USART1_TX
PB0.GPIO_Label=SENS3_PWM
PB0.Signal=S_TIM3_CH3
PB1.GPIO_Label=SENS4_PWM
PB1.Signal=S_TIM3_CH4
PB12.GPIO_Label=GYRO_CS
PB12.Signal=GPIO_Output
PB13.GPIO_Label=GYRO_SCK
PB13.Signal=SPI2_SCK
PB14.GPIO_Label=GYRO_MISO
PB14.Signal=SPI2_MISO
PB15.GPIO_Label=GYRO_MOSI
PB15.Signal=SPI2_MOSI
PB3.GPIO_Label=ENC2_B
PB3.Signal=S_TIM2_CH2
PB4.GPIO_Label=SESN1_PWM
PB4.Signal=S_TIM3_CH1
PB5.GPIO_Label=SENS2_PWM
PB5.Signal=S_TIM3_CH2
PB6.GPIO_Label=EEPROM_SCL
PB6.Signal=I2C1_SCL
PB7.GPIO_Label=EEPROM_SDA
PB7.Signal=I2C1_SDA
PB8.GPIO_Label=EDF_PWM
PB8.Signal=S_TIM10_CH1
PB9.GPIO_Label=SENS5_PWM
PB9.Signal=S_TIM11_CH1
PC0.GPIO_Label=BAT_MON
PC0.Signal=ADCx_IN10
PC1.GPIO_Label=USW1
PC1.Signal=GPIO_Input
PC10.GPIO_Label=M2A
PC10.Signal=GPIO_Output
PC11.GPIO_Label=M2B
PC11.Signal=GPIO_Output
PC12.GPIO_Label=MOTORS_EN
PC12.Signal=GPIO_Output
PC13-ANTI_TAMP.GPIO_Label=UBTN1
PC13-ANTI_TAMP.Signal=GPIO_Input
PC14-OSC32_IN.GPIO_Label=UBTN2
PC14-OSC32_IN.Signal=GPIO_Input
PC2.GPIO_Label=USW2
PC2.Signal=GPIO_Input
PC3.GPIO_Label=USW3
PC3.Signal=GPIO_Input
PC4.GPIO_Label=ULED2
PC4.Signal=GPIO_Output
PC5.GPIO_Label=ULED3
PC5.Signal=GPIO_Output
PC8.GPIO_Label=M1A
PC8.Signal=GPIO_Output
PC9.GPIO_Label=M1B
PC9.Signal=GPIO_Output
