DaMon-14/Micromouse/code_blocks/LSM6DSOX SPI test/LSM6DSOX SPI test/Core/Inc/MT6701.h

/*
 * MT3701.h
 *
 *  Created on: Sep 15, 2026
 *      Author: david
 */

#ifndef INC_MT6701_H_
#define INC_MT6701_H_

void Encoder_Init(void);
void Read_Encoder(float*, uint8_t*);


#endif /* INC_MT6701_H_ */
