DaMon-14/Micromouse/code_blocks/LSM6DSOX SPI test/LSM6DSOX SPI test/Core/Src/Code_Logic.c

/*
 * Code_Logic.c
 *
 *  Created on: Aug 22, 2026
 *      Author: david
 */
#include "main.h"
#include "Code_Logic.h"
#include "HC-05.h"
#include "MT6701.h"

#include <stdio.h>
#include <string.h>

#include "LSM6DSOX.h"

extern UART_HandleTypeDef huart2;

uint32_t previous_spi_timestamp = 0;

float rez = 0;
		uint8_t dir =0;

void User_Code_Init(void) {
	HAL_Delay(50);
	IMU_Init();
	IMU_Calibrate();
	BLE_Init();
	Encoder_Init();
	HAL_UART_Transmit(&huart2, "Connected\r\n", strlen("Connected\r\n"), 15);
}

void User_Code_Run(void) {

	// Get the current time in milliseconds
	uint32_t current_timestamp = HAL_GetTick();

	// Check if 500 milliseconds have passed to read the sensor
	if (current_timestamp - previous_spi_timestamp >= 50) {
		previous_spi_timestamp = current_timestamp;
		//uint8_t ret = Read_Reg(0x22);
		//float *motion = Read_IMU_Data_Calibrated();

		// 5. Create an empty character array (buffer) large enough to hold the message[cite: 1]
		uint8_t *data = BLE_Read_Msg(1);
		if(data){
			HAL_UART_Transmit(&huart2, data, strlen((char*) data), 10);
		}

		// 6. Format the string to display the WHO_AM_I result (expected: 0x6C)
		//sprintf(msg, "[%lu ms] LSM6DSOX WHO_AM_I: 0x%02X\r\n", current_timestamp, ret);
		//sprintf(msg, "Acc:[X:%.2fg Y:%.2fg Z:%.2fg] | Gyro:[X:%.2fdps Y:%.2fdps Z:%.2fdps]\r\n", motion[3], motion[4], motion[5], motion[0], motion[1], motion[2]);

		Read_Encoder(&rez, &dir);
		char msg[90];
		sprintf(msg, "%f\r\n", rez);
		HAL_UART_Transmit(&huart2, (uint8_t*)msg, strlen(msg), 10);
		// 7. Transmit the message over UART2[cite: 1]

	}
}

void User_Code_End(void) {

}
