DaMon-14/Micromouse/(commit log)

2026-08-22 LSM6DSOX SPI test code
2026-08-22 WHO_AM_I SLM6DSOX SPI test
2026-08-22 bad conversion of IMU data
2026-08-23 IMU conversion
2026-08-23 Read calibrated data
2026-09-08 PCB proj + components import in lib
2026-09-25 basic encoder interface
2026-09-26 gyro+ble schematic
2026-09-27 buck+LDO schematic
2026-10-23 new .ioc for pcb
2026-10-24 pin assignments KiCad
2026-10-25 schematic add: UBTNS, USWS, ENC1,2, EEPROM, ULEDS
2026-10-25 added encoders connectors
2026-10-25 footprint update
2026-10-25 motor drv + gyro connector schematic
