DaMon-14/Micromouse/(notices)

Notices in the files:
code_blocks/LSM6DSOX SPI test/LSM6DSOX SPI test/Core/Inc/main.h:
Copyright (c) 2026 STMicroelectronics.
All rights reserved.
This software is licensed under terms that can be found in the LICENSE file
